A-Barko/BT-MacroBoard/README.md

# WEEKEND PROJECT 1 - Macro keyboard 
first of a series of simple projects to be done in one or 2 weekend not accounting shipping.
## Macro keyboard specifications
4x4 switch matrix
2 potentiometer for dial
Bluetooth 
USB-C
Battery Powered 
e ink screen
ambiant temprature sensor
