A-Barko/BT-MacroBoard/notes/component-selection.md

## MCU 
STM32f072VBT6
because it was the cheapest mcu that supports usb
also it can be used for future projects without too many comprises
## Bluetooth module
nrf52810 also cheap and is the same chip used in my current wireless keyboard
there is a module also available worth looking into if avoiding rf design
## Switch Socket
the  PG151101S11 from lcsc work fine for regular MX style switches
## Screen
E ink display with spi as they look cool 
required 24p 0.5p FFC connector
## Battery 
1s battery - nothing over 5V is required as 
## Battery charger
bq252186 cheap and simple battery charger with i2c control
## knob
the cheapest option on lcsc
## Voltage regulator
