A-Barko/BT-MacroBoard/macrokeyboard/fab/macrokeyboard_bom_lcsc.csv

Quantity | Value | Designator | Footprint | LCSC Part Number
11 | 100nF | C1,C2,C3,C4,C9,C10,C25,C26,C28,C29,C39 | Capacitor_SMD:C_0603_1608Metric
4 | 4.7uF | C5,C6,C19,C31 | Capacitor_SMD:C_0603_1608Metric
1 | 10nF | C7 | Capacitor_SMD:C_0603_1608Metric
14 | 1uF | C8,C11,C13,C14,C15,C16,C17,C18,C20,C21,C22,C23,C24,C30 | Capacitor_SMD:C_0603_1608Metric
1 | 10uF | C12 | Capacitor_SMD:C_0603_1608Metric
1 | 0.8pF | C27 | Capacitor_SMD:C_0402_1005Metric
4 | 12pF | C32,C33,C37,C38 | Capacitor_SMD:C_0603_1608Metric
1 | 100pF | C36 | Capacitor_SMD:C_0603_1608Metric
1 | 1.5pF | C41 | Capacitor_SMD:C_0402_1005Metric
14 | 1N4148W | D1,D2,D3,D4,D5,D6,D7,D8,D9,D10,D11,D12,D13,D14 | Diode_SMD:D_SOD-123
3 | MBR0530 | D17,D18,D19 | Diode_SMD:D_SOD-123
5 | LED | D20,D21,D22,D23,D24 | LED_SMD:LED_0603_1608Metric
1 | 1A | F1 | Fuse:Fuse_0603_1608Metric
1 | USB_C_Receptacle_USB2.0_16P | J1 | Connector_USB:USB_C_Receptacle_HCTL_HC-TYPE-C-16P-01A
1 | Conn_01x02_MountingPin | J2 | Connector_JST:JST_PH_S2B-PH-K_1x02_P2.00mm_Horizontal
1 | Conn_02x04_Odd_Even | J3 | Connector_PinHeader_2.54mm:PinHeader_2x04_P2.54mm_Vertical
2 | Conn_01x03 | J4,J5 | Connector_PinHeader_2.54mm:PinHeader_1x03_P2.54mm_Vertical
1 | Conn_01x02 | J6 | Connector_PinHeader_2.00mm:PinHeader_1x02_P2.00mm_Vertical
1 | Chip_ant | J7 | 1_macrokeys:KH5220-A36
1 | 47uH | L1 | Inductor_SMD:L_Neosid_SM-PIC0612H
1 | 3.9nH | L2 | Inductor_SMD:L_0402_1005Metric
1 | 4.3nH | L3 | Inductor_SMD:L_0402_1005Metric
1 | Si1308EDL | Q1 | Package_TO_SOT_SMD:SOT-323_SC-70
7 | 330 | R1,R2,R3,R4,R21,R22,R23 | Resistor_SMD:R_0603_1608Metric
8 | 10k | R5,R6,R7,R8,R13,R14,R16,R24 | Resistor_SMD:R_0603_1608Metric
2 | 5.1k | R9,R10 | Resistor_SMD:R_0603_1608Metric
6 | 4.7k | R11,R12,R18,R19,R20,R25 | Resistor_SMD:R_0603_1608Metric
1 | 2.2 | R15 | Resistor_SMD:R_0603_1608Metric
4 | 100 | R17,R26,R27,R28 | Resistor_SMD:R_0603_1608Metric
2 | 10k | RV1,RV2 | 1_macrokeys:RK09K1130AH1_AAL
14 | PG151101S11 | S1,S2,S5,S6,S7,S8,S9,S10,S11,S12,S13,S14,S15,S16 | 1_macrokeys:Kailh_socket_MX
4 | SW_Push | SW3,SW4,SW5,SW6 | 1_macrokeys:button_smol
2 | 10k @ 25 | TH1,TH2 | Resistor_SMD:R_0603_1608Metric
1 | 10k @ 25 | TH3 | Resistor_SMD:R_0805_2012Metric
1 | STM32F072VBTx | U1 | Package_QFP:LQFP-100_14x14mm_P0.5mm
1 | nRF52810-QCxx | U2 | Package_DFN_QFN:QFN-32-1EP_5x5mm_P0.5mm_EP3.6x3.6mm
1 | BQ25186DLHR | U3 | 1_macrokeys:WSON10_2P2X2_TEX
1 | RV-3028-C7 | U4 | Package_SON:MicroCrystal_C7_SON-8_1.5x3.2mm_P0.9mm
1 | E-INK_Display_Conn | U5 | 1_macrokeys:AMPHENOL_F3311A7H121024E200
1 | DS8572-33S5 | U6 | 1_macrokeys:SOT_233DBVR_TEX
2 | SK12D07VG4 | U8,U9 | 1_macrokeys:SK12D07VG4
1 | 32.768KHz | Y1 | Crystal:Crystal_SMD_3215-2Pin_3.2x1.5mm
1 | 32MHz | Y2 | Crystal:Crystal_SMD_2520-4Pin_2.5x2.0mm
