A-Barko/BT-MacroBoard/macrokeyboard/macrokeyboard.kicad_pcb

## KiCad design macrokeyboard/macrokeyboard.kicad_pcb (2026-10-13)

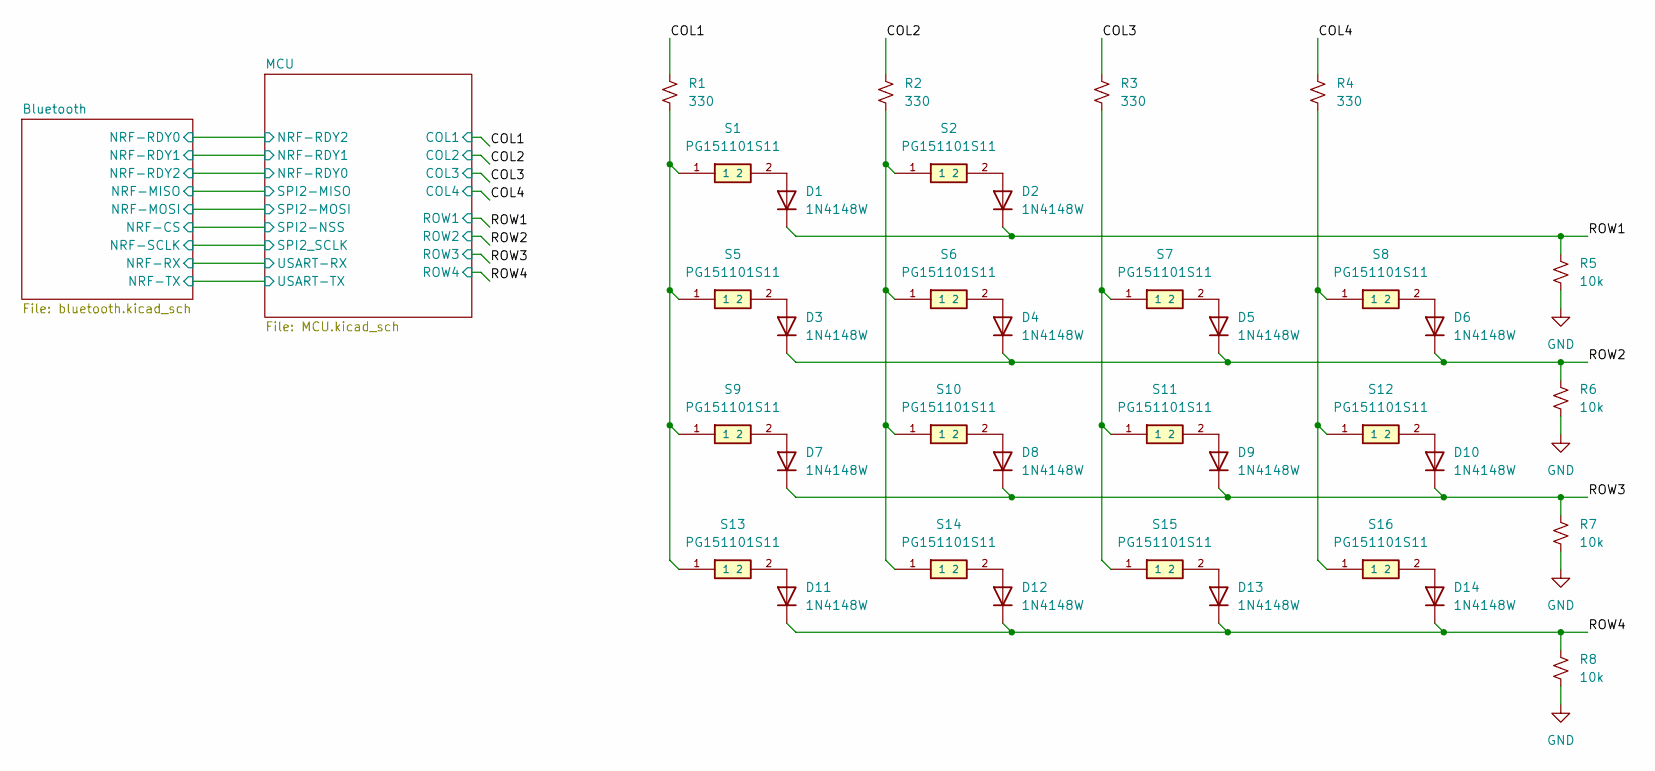
[picture p1: schematic macrokeyboard.kicad_sch]

Parts:
D1, D2, D3, D4, D5, D6, D7, D8, D9, D10, D11, D12, D13, D14: 1N4148W; D_SOD-123
R1, R2, R3, R4: 330; R_0603_1608Metric
R5, R6, R7, R8: 10k; R_0603_1608Metric
S1, S2, S5, S6, S7, S8, S9, S10, S11, S12, S13, S14, S15, S16: PG151101S11; Kailh_socket_MX; PARTREV A

Connections:
/COL1: R1.2; also elsewhere on the board
/COL2: R2.2; also elsewhere on the board
/COL3: R3.2; also elsewhere on the board
/COL4: R4.2; also elsewhere on the board
/ROW1: D1.1 (K), D2.1 (K), R5.1; also elsewhere on the board
/ROW2: D3.1 (K), D4.1 (K), D5.1 (K), D6.1 (K), R6.1; also elsewhere on the board
/ROW3: D7.1 (K), D8.1 (K), D9.1 (K), D10.1 (K), R7.1; also elsewhere on the board
/ROW4: D11.1 (K), D12.1 (K), D13.1 (K), D14.1 (K), R8.1; also elsewhere on the board
GND: R5.2, R6.2, R7.2, R8.2; also elsewhere on the board
unnamed: D1.2 (A), S1.2
unnamed: D2.2 (A), S2.2
unnamed: D3.2 (A), S5.2
unnamed: D4.2 (A), S6.2
unnamed: D5.2 (A), S7.2
unnamed: D6.2 (A), S8.2
unnamed: D7.2 (A), S9.2
unnamed: D8.2 (A), S10.2
unnamed: D9.2 (A), S11.2
unnamed: D10.2 (A), S12.2
unnamed: D11.2 (A), S13.2
unnamed: D12.2 (A), S14.2
unnamed: D13.2 (A), S15.2
unnamed: D14.2 (A), S16.2
unnamed: R1.1, S1.1, S5.1, S9.1, S13.1
unnamed: R2.1, S2.1, S6.1, S10.1, S14.1
unnamed: R3.1, S7.1, S11.1, S15.1
unnamed: R4.1, S8.1, S12.1, S16.1

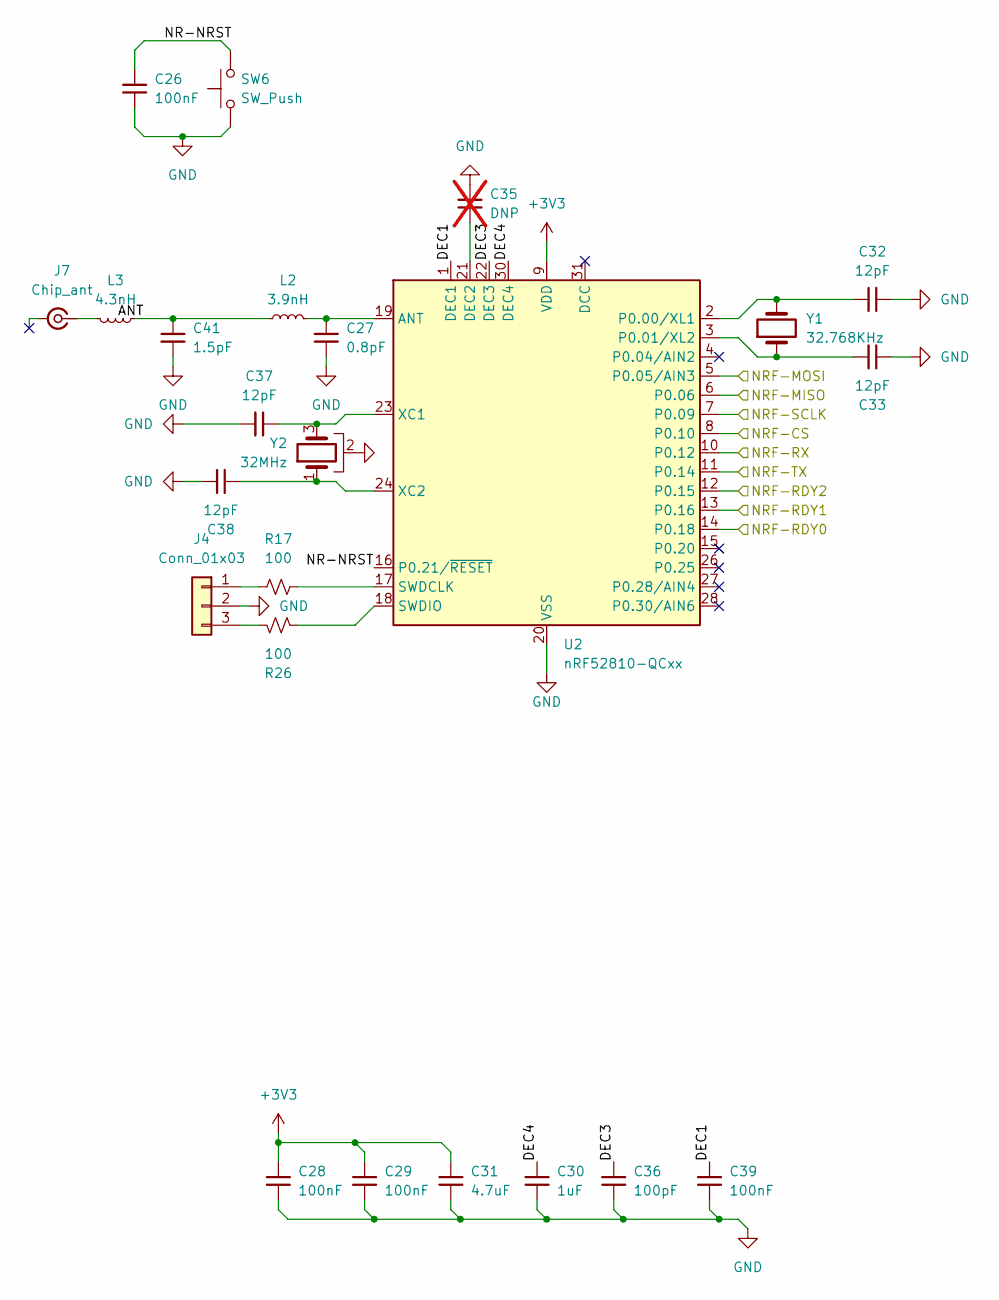
[picture p2: schematic bluetooth.kicad_sch]

Parts:
C26, C28, C29, C39: 100nF; C_0603_1608Metric
C27: 0.8pF; C_0402_1005Metric
C30: 1uF; C_0603_1608Metric
C31: 4.7uF; C_0603_1608Metric
C32, C33, C37, C38: 12pF; C_0603_1608Metric
C35: DNP; C_0603_1608Metric; not fitted
C36: 100pF; C_0603_1608Metric
C41: 1.5pF; C_0402_1005Metric
J4: Conn_01x03; PinHeader_1x03_P2.54mm_Vertical
J7: Chip_ant; KH5220-A36
L2: 3.9nH; L_0402_1005Metric
L3: 4.3nH; L_0402_1005Metric
R17, R26: 100; R_0603_1608Metric
SW6: SW_Push; button_smol
U2: nRF52810-QCxx; QFN-32-1EP_5x5mm_P0.5mm_EP3.6x3.6mm
Y1: 32.768KHz; Crystal_SMD_3215-2Pin_3.2x1.5mm
Y2: 32MHz; Crystal_SMD_2520-4Pin_2.5x2.0mm

Connections:
+3V3: C28.1, C29.1, C31.1, U2.9 (VDD), U2.25 (VDD), U2.32 (VDD); also elsewhere on the board
/Bluetooth/ANT: C41.2, L2.1, L3.1
/Bluetooth/DEC1: C39.2, U2.1 (DEC1)
/Bluetooth/DEC3: C36.2, U2.22 (DEC3)
/Bluetooth/DEC4: C30.1, U2.30 (DEC4)
/Bluetooth/NR-NRST: C26.2, SW6.2, U2.16 (P0.21/~RESET)
/Bluetooth/NRF-CS: U2.8 (P0.10); also elsewhere on the board
/Bluetooth/NRF-MISO: U2.6 (P0.06); also elsewhere on the board
/Bluetooth/NRF-MOSI: U2.5 (P0.05/AIN3); also elsewhere on the board
/Bluetooth/NRF-RDY0: U2.14 (P0.18); also elsewhere on the board
/Bluetooth/NRF-RDY1: U2.13 (P0.16); also elsewhere on the board
/Bluetooth/NRF-RDY2: U2.12 (P0.15); also elsewhere on the board
/Bluetooth/NRF-RX: U2.10 (P0.12); also elsewhere on the board
/Bluetooth/NRF-SCLK: U2.7 (P0.09); also elsewhere on the board
/Bluetooth/NRF-TX: U2.11 (P0.14); also elsewhere on the board
GND: C26.1, C27.1, C28.2, C29.2, C30.2, C31.2, C32.2, C33.2, C35.2, C36.1, C37.2, C38.2, C39.1, C41.1, J4.2, SW6.1, U2.20 (VSS), U2.29 (VSS), U2.33 (VSS), Y2.2; also elsewhere on the board
unnamed: J4.1, R17.1
unnamed: J4.3, R26.1
unnamed: J7.1 (In_1), L3.2
unnamed: C27.2, L2.2, U2.19 (ANT)
unnamed: C35.1, U2.21 (DEC2)
unnamed: C32.1, U2.2 (P0.00/XL1), Y1.2
unnamed: C33.1, U2.3 (P0.01/XL2), Y1.1
unnamed: R17.2, U2.17 (SWDCLK)
unnamed: R26.2, U2.18 (SWDIO)
unnamed: C37.1, U2.23 (XC1), Y2.3
unnamed: C38.1, U2.24 (XC2), Y2.1

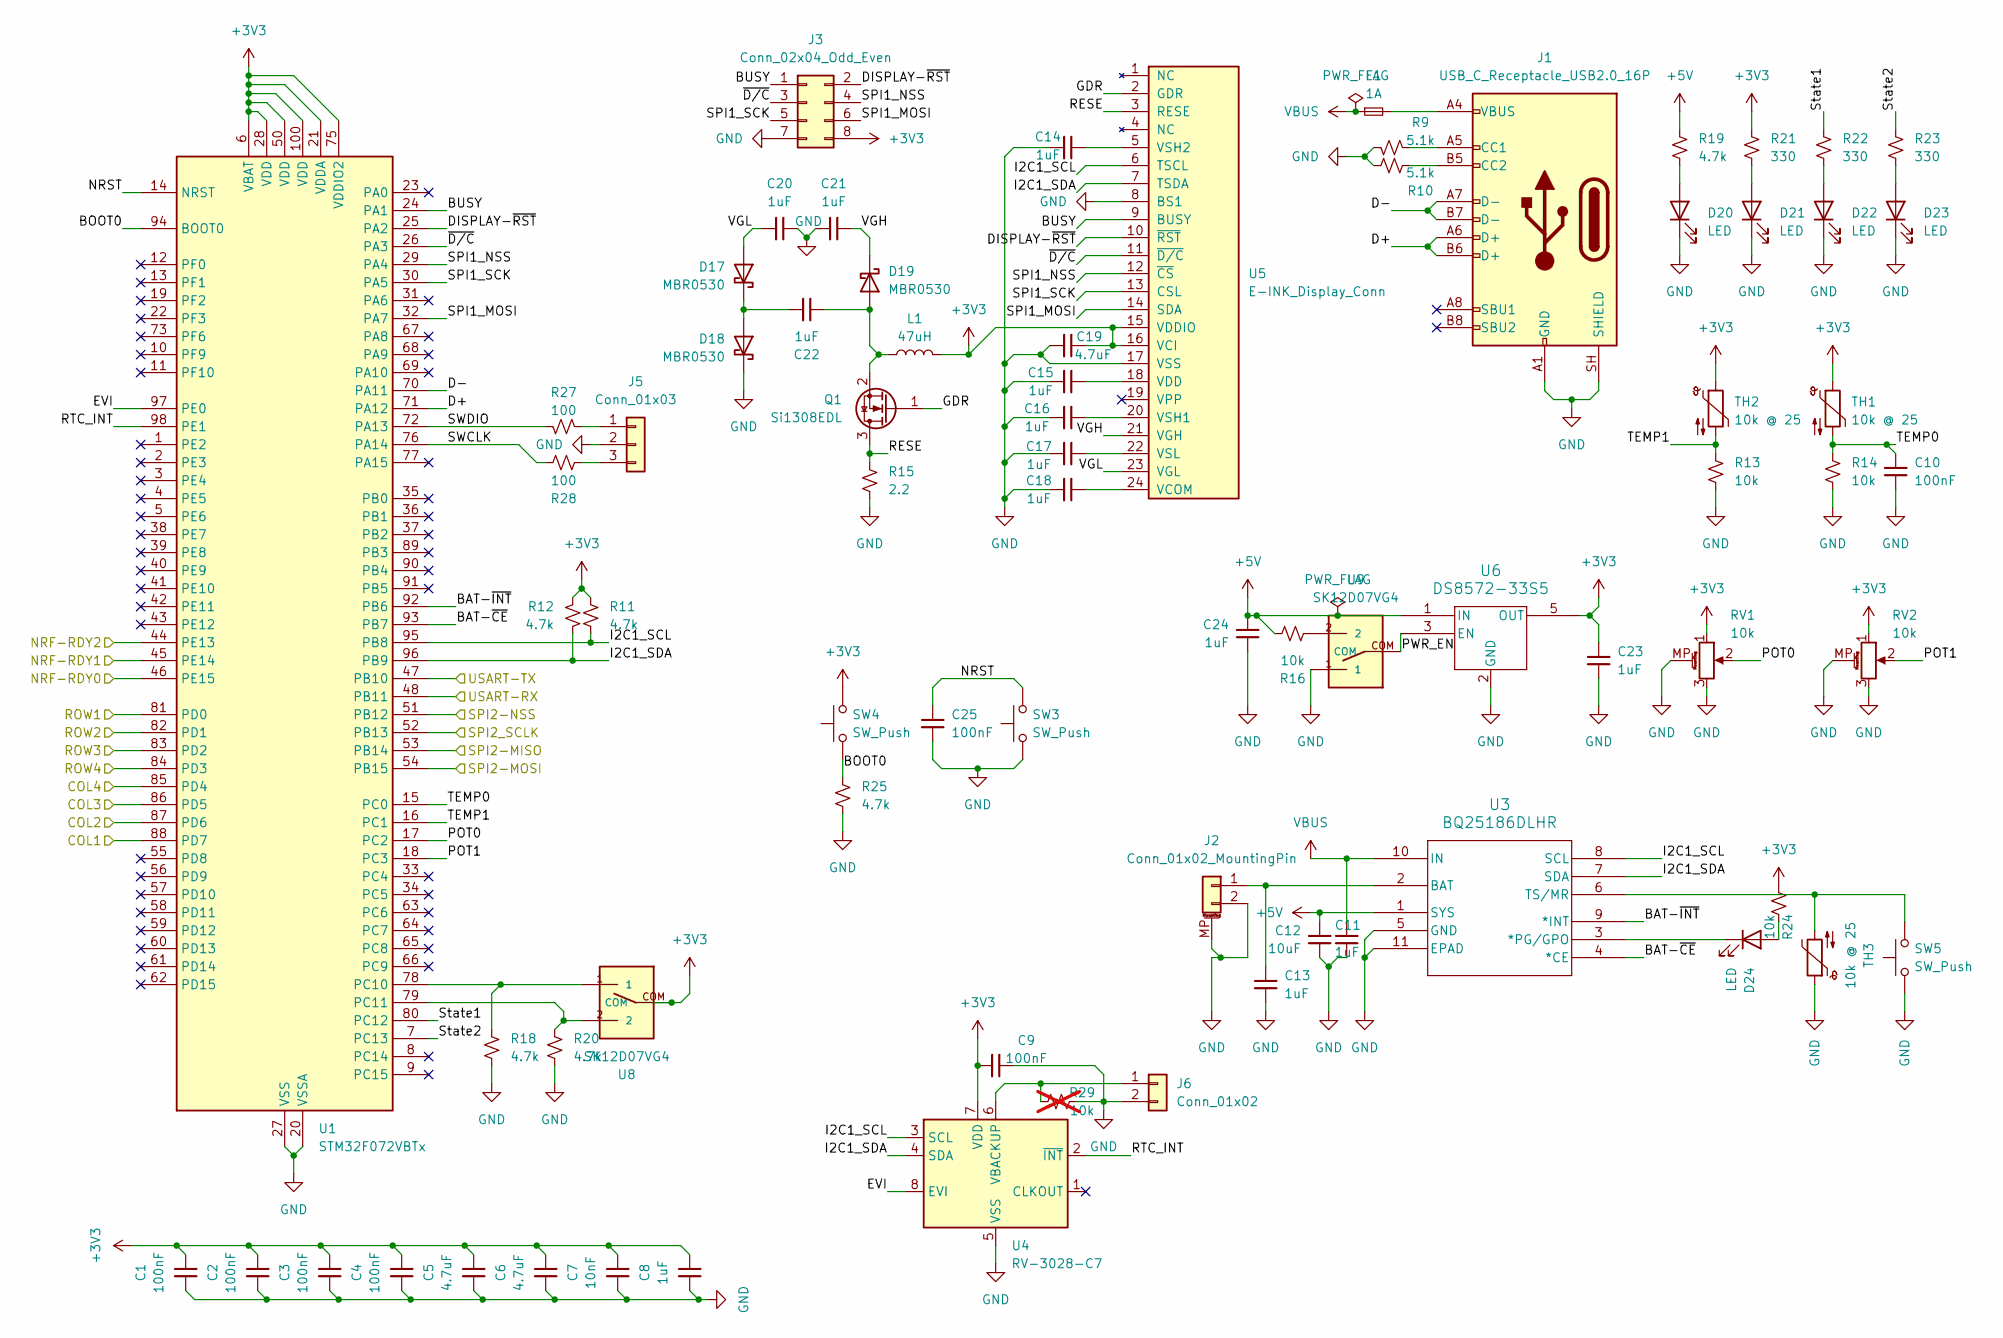
[picture p3: schematic MCU.kicad_sch]

Parts:
C1, C2, C3, C4, C9, C10, C25: 100nF; C_0603_1608Metric
C5, C6, C19: 4.7uF; C_0603_1608Metric
C7: 10nF; C_0603_1608Metric
C8, C11, C13, C14, C15, C16, C17, C18, C20, C21, C22, C23, C24: 1uF; C_0603_1608Metric
C12: 10uF; C_0603_1608Metric
D17, D18, D19: MBR0530; D_SOD-123
D20, D21, D22, D23, D24: LED; LED_0603_1608Metric
F1: 1A; Fuse_0603_1608Metric
J1: USB_C_Receptacle_USB2.0_16P; USB_C_Receptacle_HCTL_HC-TYPE-C-16P-01A
J2: Conn_01x02_MountingPin; JST_PH_S2B-PH-K_1x02_P2.00mm_Horizontal
J3: Conn_02x04_Odd_Even; PinHeader_2x04_P2.54mm_Vertical
J5: Conn_01x03; PinHeader_1x03_P2.54mm_Vertical
J6: Conn_01x02; PinHeader_1x02_P2.00mm_Vertical
L1: 47uH; L_Neosid_SM-PIC0612H
Q1: Si1308EDL; SOT-323_SC-70
R9, R10: 5.1k; R_0603_1608Metric
R11, R12, R18, R19, R20, R25: 4.7k; R_0603_1608Metric
R13, R14, R16, R24: 10k; R_0603_1608Metric
R15: 2.2; R_0603_1608Metric
R21, R22, R23: 330; R_0603_1608Metric
R27, R28: 100; R_0603_1608Metric
R29: 10k; R_0603_1608Metric; not fitted
RV1, RV2: 10k; RK09K1130AH1_AAL
SW3, SW4, SW5: SW_Push; button_smol
TH1, TH2: 10k @ 25; R_0603_1608Metric
TH3: 10k @ 25; R_0805_2012Metric
U1: STM32F072VBTx; LQFP-100_14x14mm_P0.5mm
U3: BQ25186DLHR; WSON10_2P2X2_TEX
U4: RV-3028-C7; MicroCrystal_C7_SON-8_1.5x3.2mm_P0.9mm
U5: E-INK_Display_Conn; AMPHENOL_F3311A7H121024E200
U6: DS8572-33S5; SOT_233DBVR_TEX
U8, U9: SK12D07VG4

Connections:
+3V3: C1.2, C2.2, C3.2, C4.2, C5.2, C6.2, C7.2, C8.2, C9.1, C19.2, C23.1, J3.8, L1.2, R11.2, R12.2, R21.1, R24.2, RV1.1, RV2.1, SW4.2, TH1.1, TH2.1, U1.6 (VBAT), U1.21 (VDDA), U1.28 (VDD), U1.50 (VDD), U1.75 (VDDIO2), U1.100 (VDD), U4.7 (VDD), U5.15 (VDDIO), U5.16 (VCI), U6.5 (OUT), U8.COM; also elsewhere on the board
+5V: C12.1, C24.1, R16.1, R19.1, U3.1 (SYS), U6.1 (IN)
/MCU/BAT-~CE: U1.93 (PB7), U3.4 (*CE); also elsewhere on the board
/MCU/BAT-~INT: U1.92 (PB6), U3.9 (*INT); also elsewhere on the board
/MCU/BOOT0: R25.1, SW4.1, U1.94 (BOOT0); also elsewhere on the board
/MCU/BUSY: J3.1, U1.24 (PA1), U5.9 (BUSY); also elsewhere on the board
/MCU/D+: J1.A6 (D+), J1.B6 (D+), U1.71 (PA12); also elsewhere on the board
/MCU/D-: J1.A7 (D-), J1.B7 (D-), U1.70 (PA11); also elsewhere on the board
/MCU/DISPLAY-~RST: J3.2, U1.25 (PA2), U5.10 (~RST); also elsewhere on the board
/MCU/EVI: U1.97 (PE0), U4.8 (EVI); also elsewhere on the board
/MCU/GDR: Q1.1 (G), U5.2 (GDR)
/MCU/I2C1_SCL: R11.1, U1.95 (PB8), U3.8 (SCL), U4.3 (SCL), U5.6 (TSCL); also elsewhere on the board
/MCU/I2C1_SDA: R12.1, U1.96 (PB9), U3.7 (SDA), U4.4 (SDA), U5.7 (TSDA); also elsewhere on the board
/MCU/NRST: C25.2, SW3.2, U1.14 (NRST); also elsewhere on the board
/MCU/POT0: RV1.2, U1.17 (PC2); also elsewhere on the board
/MCU/POT1: RV2.2, U1.18 (PC3); also elsewhere on the board
/MCU/PWR_EN: U6.3 (EN), U9.COM
/MCU/RESE: Q1.3 (D), R15.2, U5.3 (RESE)
/MCU/RTC_INT: U1.98 (PE1), U4.2 (~INT); also elsewhere on the board
/MCU/SPI1_MOSI: J3.6, U1.32 (PA7), U5.14 (SDA); also elsewhere on the board
/MCU/SPI1_NSS: J3.4, U1.29 (PA4), U5.12 (~CS); also elsewhere on the board
/MCU/SPI1_SCK: J3.5, U1.30 (PA5), U5.13 (CSL); also elsewhere on the board
/MCU/SWCLK: R28.2, U1.76 (PA14); also elsewhere on the board
/MCU/SWDIO: R27.2, U1.72 (PA13); also elsewhere on the board
/MCU/State1: R22.1, U1.80 (PC12); also elsewhere on the board
/MCU/State2: R23.1, U1.7 (PC13); also elsewhere on the board
/MCU/TEMP0: C10.1, R14.1, TH1.2, U1.15 (PC0); also elsewhere on the board
/MCU/TEMP1: R13.1, TH2.2, U1.16 (PC1); also elsewhere on the board
/MCU/VGH: C21.2, D19.1 (K), U5.21 (VGH)
/MCU/VGL: C20.1, D17.2 (A), U5.23 (VGL)
/MCU/~D/C: J3.3, U1.26 (PA3), U5.11 (~D/C); also elsewhere on the board
GND: C1.1, C2.1, C3.1, C4.1, C5.1, C6.1, C7.1, C8.1, C9.2, C10.2, C11.2, C12.2, C13.2, C14.2, C15.2, C16.2, C17.2, C18.2, C19.1, C20.2, C21.1, C23.2, C24.2, C25.1, D18.1 (K), D20.1 (K), D21.1 (K), D22.1 (K), D23.1 (K), J1.A1 (GND), J1.A12 (GND), J1.B1 (GND), J1.B12 (GND), J1.SH (SHIELD), J2.2, J2.MP (MountPin), J3.7, J5.2, J6.2, R9.2, R10.2, R13.2, R14.2, R15.1, R18.2, R20.2, R25.2, R29.1, RV1.3, RV1.MP (MountPin), RV2.3, RV2.MP (MountPin), SW3.1, SW5.1, TH3.1, U1.20 (VSSA), U1.27 (VSS), U1.49 (VSS), U1.74 (VSS), U1.99 (VSS), U3.5 (GND), U3.11 (EPAD), U4.5 (VSS), U5.8 (BS1), U5.17 (VSS), U6.2 (GND), U9.1; also elsewhere on the board
unnamed: C22.1, D17.1 (K), D18.2 (A)
unnamed: C22.2, D19.2 (A), L1.1, Q1.2 (S)
unnamed: D20.2 (A), R19.2
unnamed: D21.2 (A), R21.2
unnamed: D22.2 (A), R22.2
unnamed: D23.2 (A), R23.2
unnamed: D24.2 (A), R24.1
unnamed: D24.1 (K), U3.3 (*PG/GPO)
unnamed: F1.2, J1.A4 (VBUS), J1.A9 (VBUS), J1.B4 (VBUS), J1.B9 (VBUS)
unnamed: J1.A5 (CC1), R9.1
unnamed: J1.B5 (CC2), R10.1
unnamed: C13.1, J2.1, U3.2 (BAT)
unnamed: J5.1, R27.1
unnamed: J5.3, R28.1
unnamed: J6.1, R29.2, U4.6 (VBACKUP)
unnamed: R16.2, U9.2
unnamed 91: R18.1, U1.78 (PC10), U8.1; also elsewhere on the board
unnamed 92: R20.1, U1.79 (PC11), U8.2; also elsewhere on the board
unnamed: SW5.2, TH3.2, U3.6 (TS/MR)
unnamed: C18.1, U5.24 (VCOM)
unnamed: C15.1, U5.18 (VDD)
unnamed: C16.1, U5.20 (VSH1)
unnamed: C14.1, U5.5 (VSH2)
unnamed: C17.1, U5.22 (VSL)
VBUS: C11.1, F1.1, U3.10 (IN)

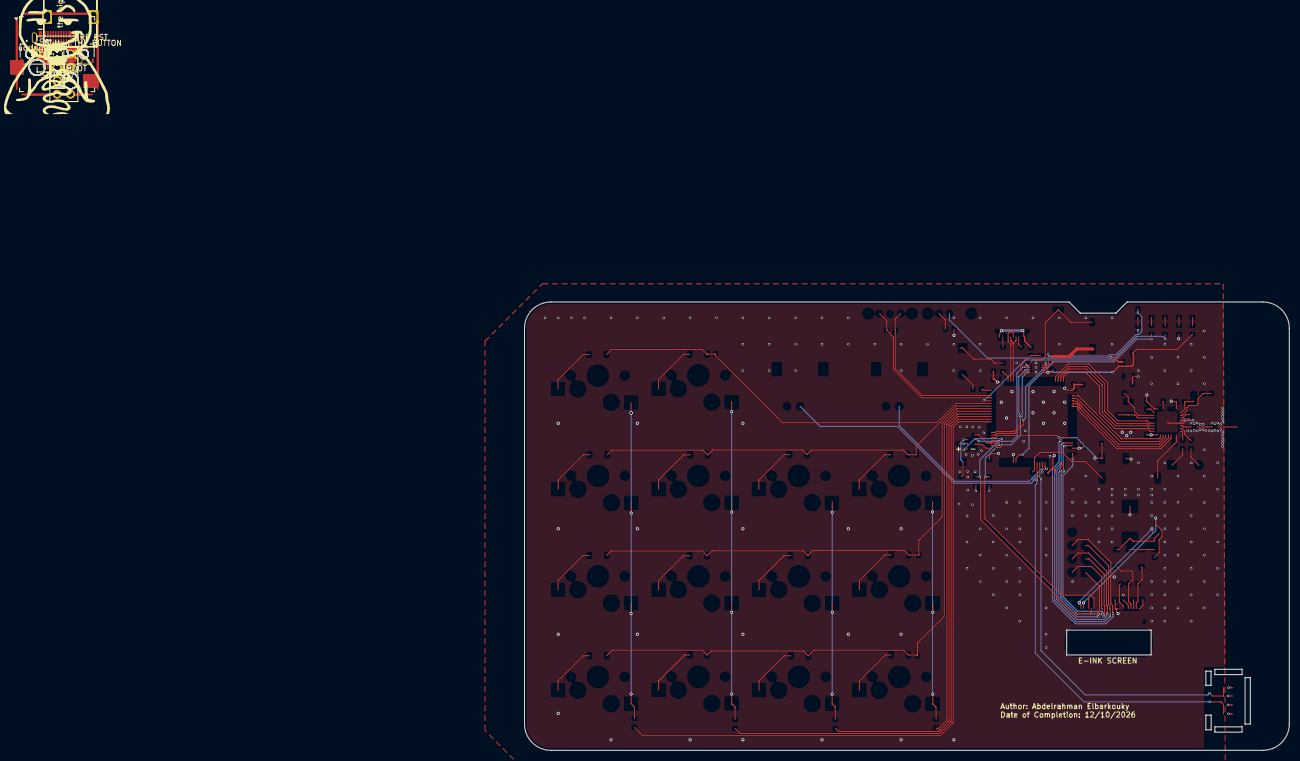
[picture p4: board macrokeyboard.kicad_pcb from above]

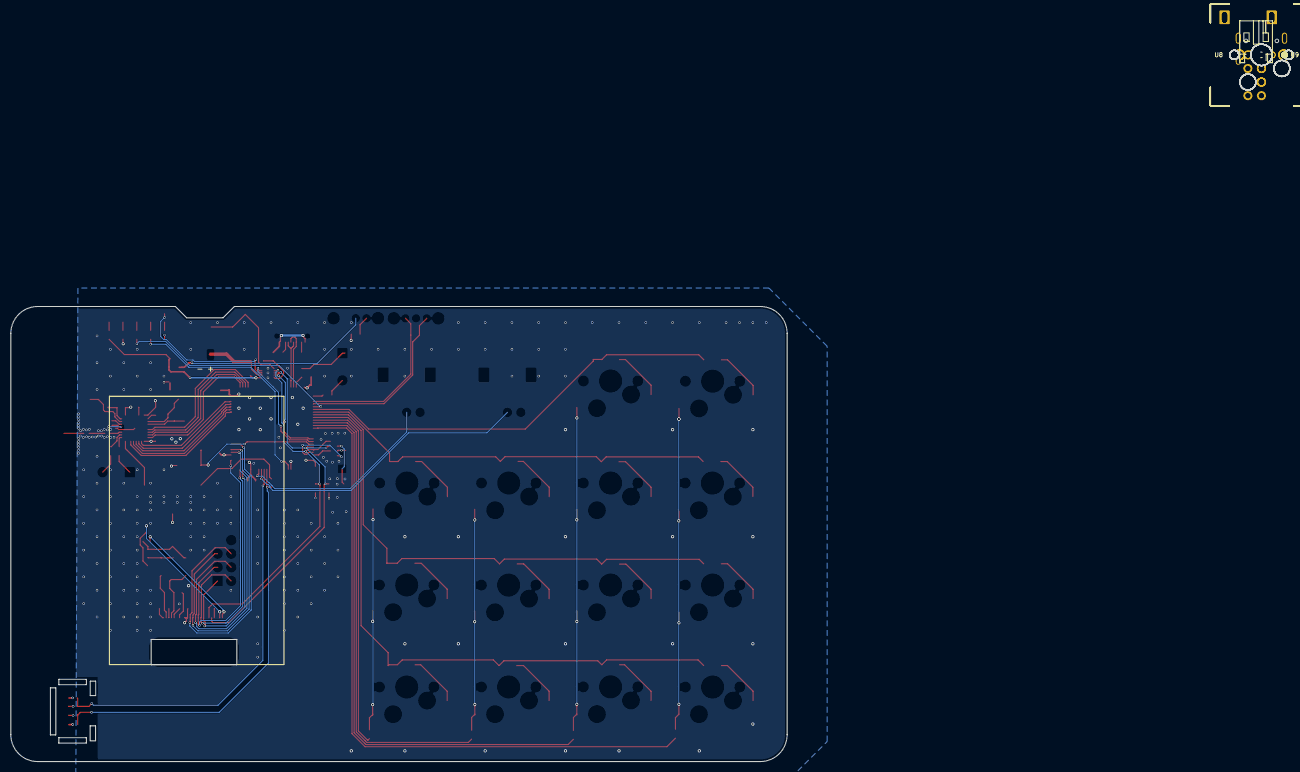
[picture p5: board macrokeyboard.kicad_pcb from below]

Board: 4 copper layers, 145.0 x 85.0 mm, 135 parts (2 on the bottom side), 108 nets.

Other parts of the board:
the big man: STM32F072VBTx; LQFP-100_14x14mm_P0.5mm

Their connections:
+3V3: the big man.6 (VBAT), the big man.21 (VDDA), the big man.28 (VDD), the big man.50 (VDD), the big man.75 (VDDIO2), the big man.100 (VDD); also elsewhere on the board
/Bluetooth/NRF-CS: the big man.51 (PB12); also elsewhere on the board
/Bluetooth/NRF-MISO: the big man.53 (PB14); also elsewhere on the board
/Bluetooth/NRF-MOSI: the big man.54 (PB15); also elsewhere on the board
/Bluetooth/NRF-RDY0: the big man.44 (PE13); also elsewhere on the board
/Bluetooth/NRF-RDY1: the big man.45 (PE14); also elsewhere on the board
/Bluetooth/NRF-RDY2: the big man.46 (PE15); also elsewhere on the board
/Bluetooth/NRF-RX: the big man.48 (PB11); also elsewhere on the board
/Bluetooth/NRF-SCLK: the big man.52 (PB13); also elsewhere on the board
/Bluetooth/NRF-TX: the big man.47 (PB10); also elsewhere on the board
/COL1: the big man.88 (PD7); also elsewhere on the board
/COL2: the big man.87 (PD6); also elsewhere on the board
/COL3: the big man.86 (PD5); also elsewhere on the board
/COL4: the big man.85 (PD4); also elsewhere on the board
/MCU/BAT-~CE: the big man.93 (PB7); also elsewhere on the board
/MCU/BAT-~INT: the big man.92 (PB6); also elsewhere on the board
/MCU/BOOT0: the big man.94 (BOOT0); also elsewhere on the board
/MCU/BUSY: the big man.24 (PA1); also elsewhere on the board
/MCU/D+: the big man.71 (PA12); also elsewhere on the board
/MCU/D-: the big man.70 (PA11); also elsewhere on the board
/MCU/DISPLAY-~RST: the big man.25 (PA2); also elsewhere on the board
/MCU/EVI: the big man.97 (PE0); also elsewhere on the board
/MCU/I2C1_SCL: the big man.95 (PB8); also elsewhere on the board
/MCU/I2C1_SDA: the big man.96 (PB9); also elsewhere on the board
/MCU/NRST: the big man.14 (NRST); also elsewhere on the board
/MCU/POT0: the big man.17 (PC2); also elsewhere on the board
/MCU/POT1: the big man.18 (PC3); also elsewhere on the board
/MCU/RTC_INT: the big man.98 (PE1); also elsewhere on the board
/MCU/SPI1_MOSI: the big man.32 (PA7); also elsewhere on the board
/MCU/SPI1_NSS: the big man.29 (PA4); also elsewhere on the board
/MCU/SPI1_SCK: the big man.30 (PA5); also elsewhere on the board
/MCU/SWCLK: the big man.76 (PA14); also elsewhere on the board
/MCU/SWDIO: the big man.72 (PA13); also elsewhere on the board
/MCU/State1: the big man.80 (PC12); also elsewhere on the board
/MCU/State2: the big man.7 (PC13); also elsewhere on the board
/MCU/TEMP0: the big man.15 (PC0); also elsewhere on the board
/MCU/TEMP1: the big man.16 (PC1); also elsewhere on the board
/MCU/~D/C: the big man.26 (PA3); also elsewhere on the board
/ROW1: the big man.81 (PD0); also elsewhere on the board
/ROW2: the big man.82 (PD1); also elsewhere on the board
/ROW3: the big man.83 (PD2); also elsewhere on the board
/ROW4: the big man.84 (PD3); also elsewhere on the board
GND: the big man.20 (VSSA), the big man.27 (VSS), the big man.49 (VSS), the big man.74 (VSS), the big man.99 (VSS); also elsewhere on the board
unnamed 91: the big man.78 (PC10); also elsewhere on the board
unnamed 92: the big man.79 (PC11); also elsewhere on the board
