A-Barko/BT-MacroBoard/(commit log)

2026-09-26 first commit need to fix antenna and switches
    [MCU.kicad_sch, bluetooth.kicad_sch, macrokeyboard.kicad_pcb, macrokeyboard.kicad_sch, power.kicad_sch]
2026-10-12 PCB completion
2026-10-12 added production files and BOM
